kanak1506/IMU-Based-Vehicle-Dynamics-Measurement-System/(commit log)

2026-07-13 Rewrite README to full engineering standard
    Replace the 27-line README with a full writeup drawing from report.md
    and the handbook: hero/badges, problem statement, objectives, features,
    Mermaid system + dashboard architecture, hardware (I2C wiring, PCB spec,
    Gerber link), firmware/pipeline/dashboard software tables, methodology
    (quaternion->Euler, filtering, ISO 4138 regression), results (synthetic
    ground truth + real-vehicle testing status, TODOs where numbers are
    still pending), folder structure, install/usage, future improvements,
    lessons learned, and a references table with verified external links.
2026-07-14 Fix portfolio audit issues: privacy, theme bug, naming, results
    - Remove hardcoded personal OneDrive path from step08_serial_logger.py
    - Fix broken Streamlit theme (was in unused root config.toml instead
    of .streamlit/config.toml, which Streamlit actually reads)
    - Fix Step01 sketch folder/file double-extension naming
    (Step01_BNO085_Initialization.ino/...ino.ino -> consistent with
    Step02-07 siblings)
    - Fill in synthetic validation results in README (ran generatedata.py
    + step11_iso4138_analysis.py: recovers 9.501 deg/g vs 9.5 deg/g
    ground truth, R^2 > 0.999)
    [Step01_BNO085_Initialization.ino, step08_serial_logger.py]
2026-07-14 Fix typo in README for sensor health description
